dorisoy/Dorisoy.BTRemote/3D_PCB1_1_2026-03-20.png

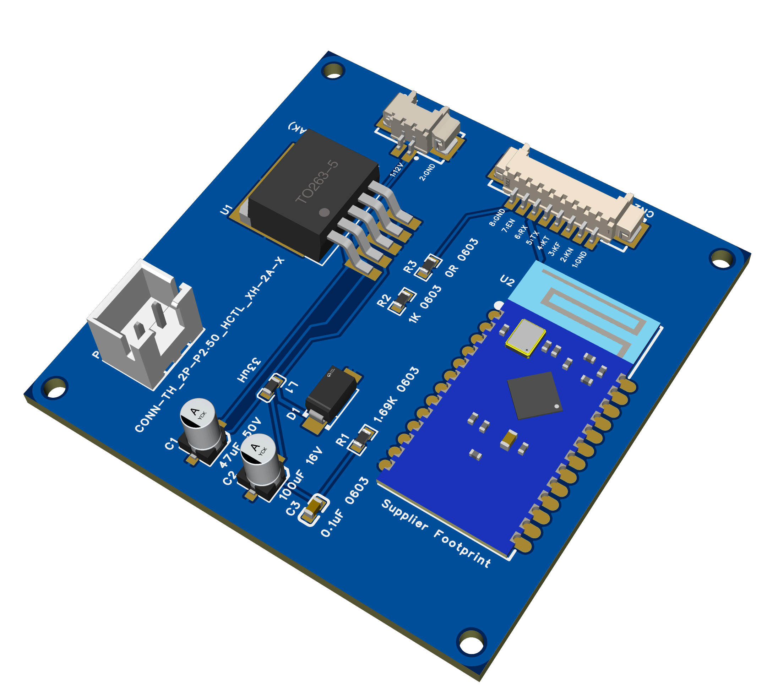
3D_PCB1_1_2026-03-20.png
