dorisoy/Dorisoy.BTRemote/b5cf8264-b6f2-4770-b07a-7b15c572c21a.png

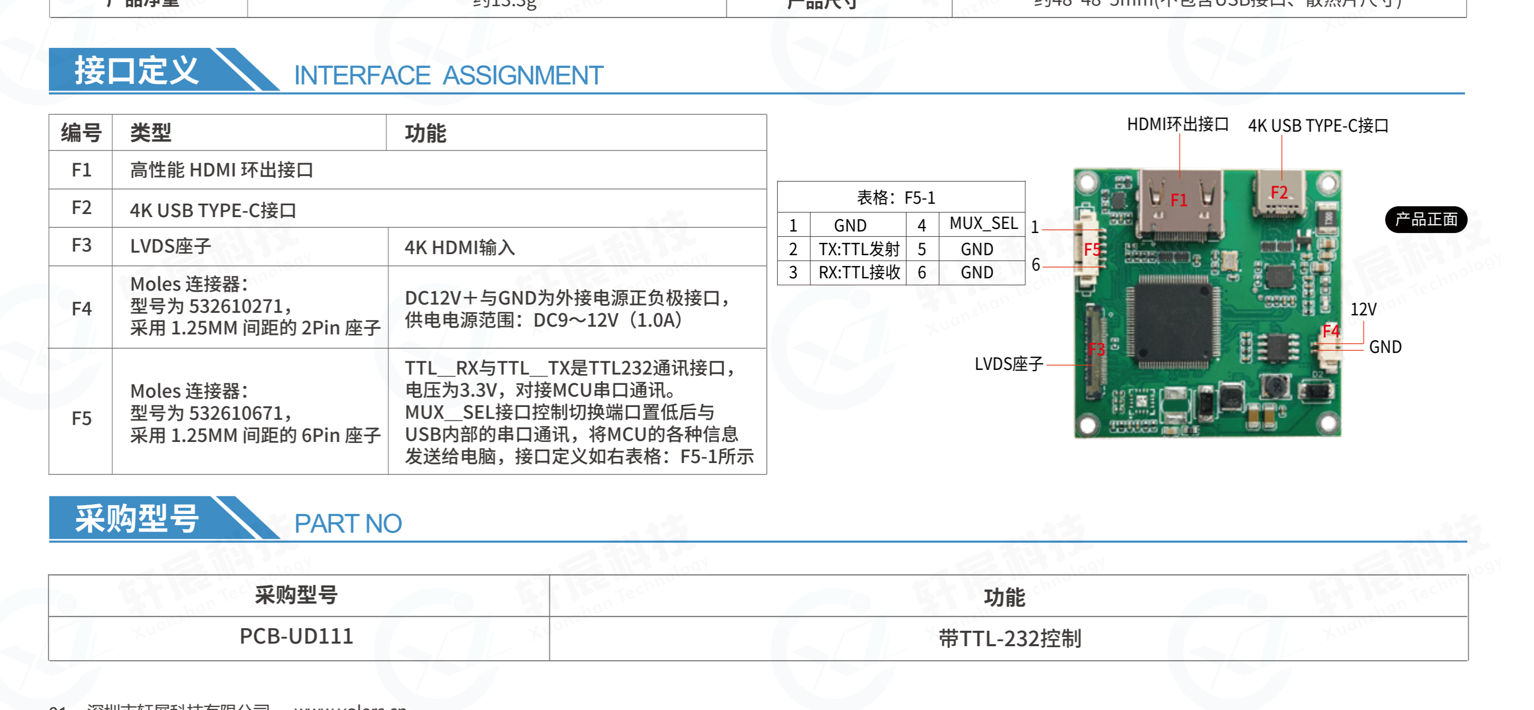
b5cf8264-b6f2-4770-b07a-7b15c572c21a.png
