dorisoy/Dorisoy.BTRemote/PCB_PCB1_1_2026-03-20.png

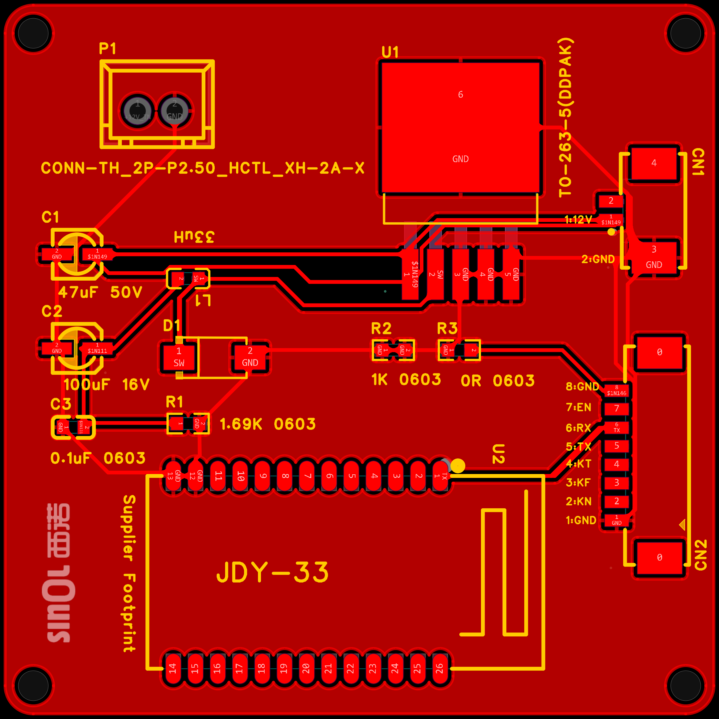
PCB_PCB1_1_2026-03-20.png
