dorisoy/Dorisoy.BTRemote/SCH_USB_TYPE-C 采集模块扩展板(2P)_1-P1_2026-03-26.png

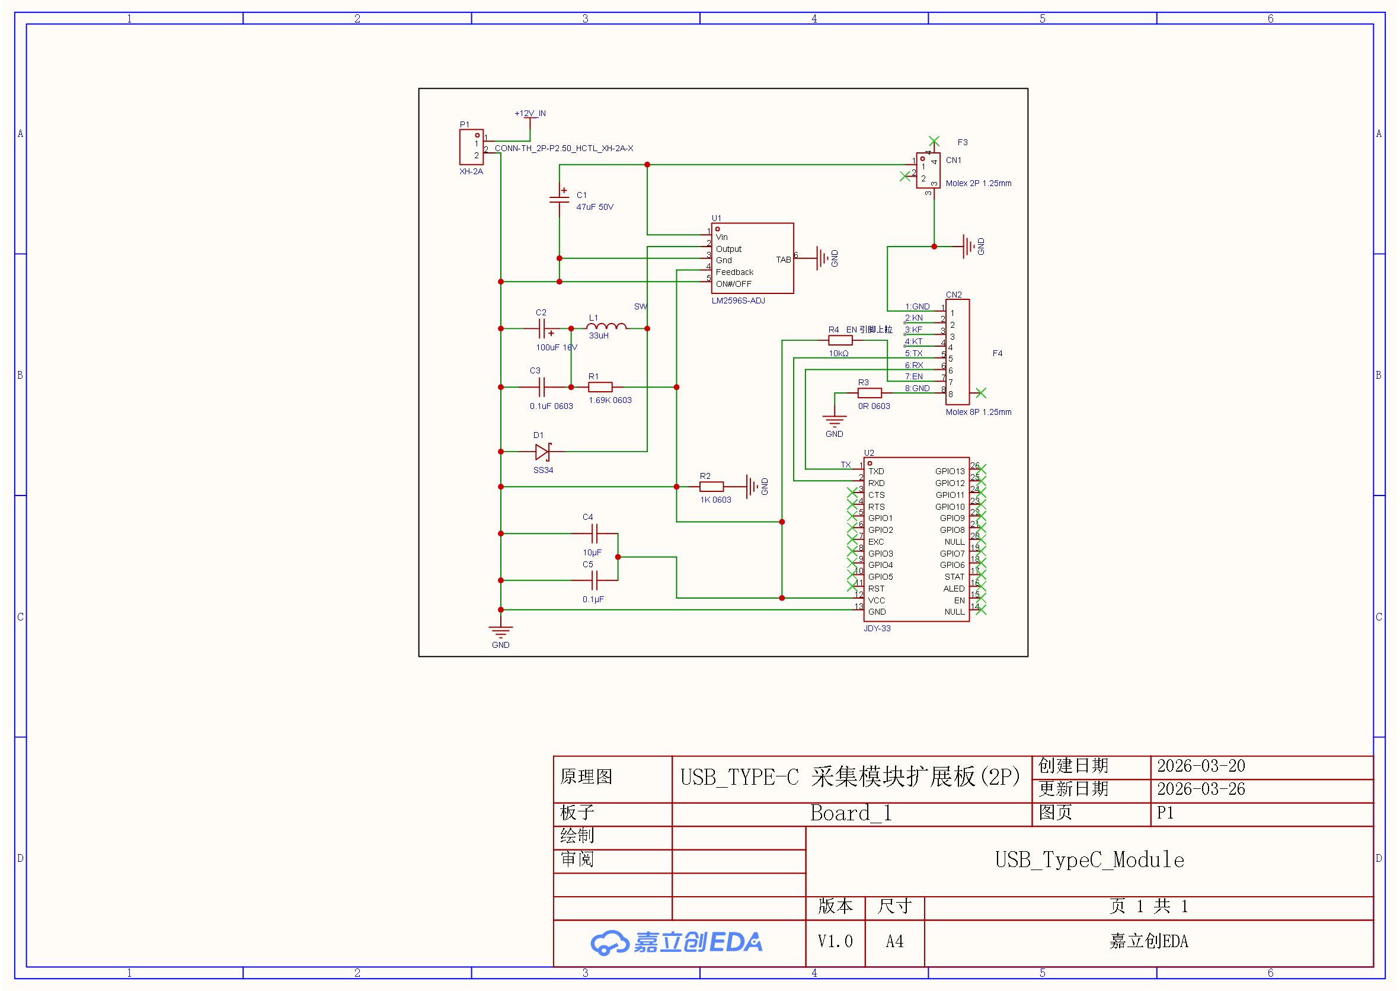
SCH_USB_TYPE-C 采集模块扩展板(2P)_1-P1_2026-03-26.png
