dorisoy/Dorisoy.BTRemote/SCH_蓝牙_1-蓝牙_2026-03-27.png

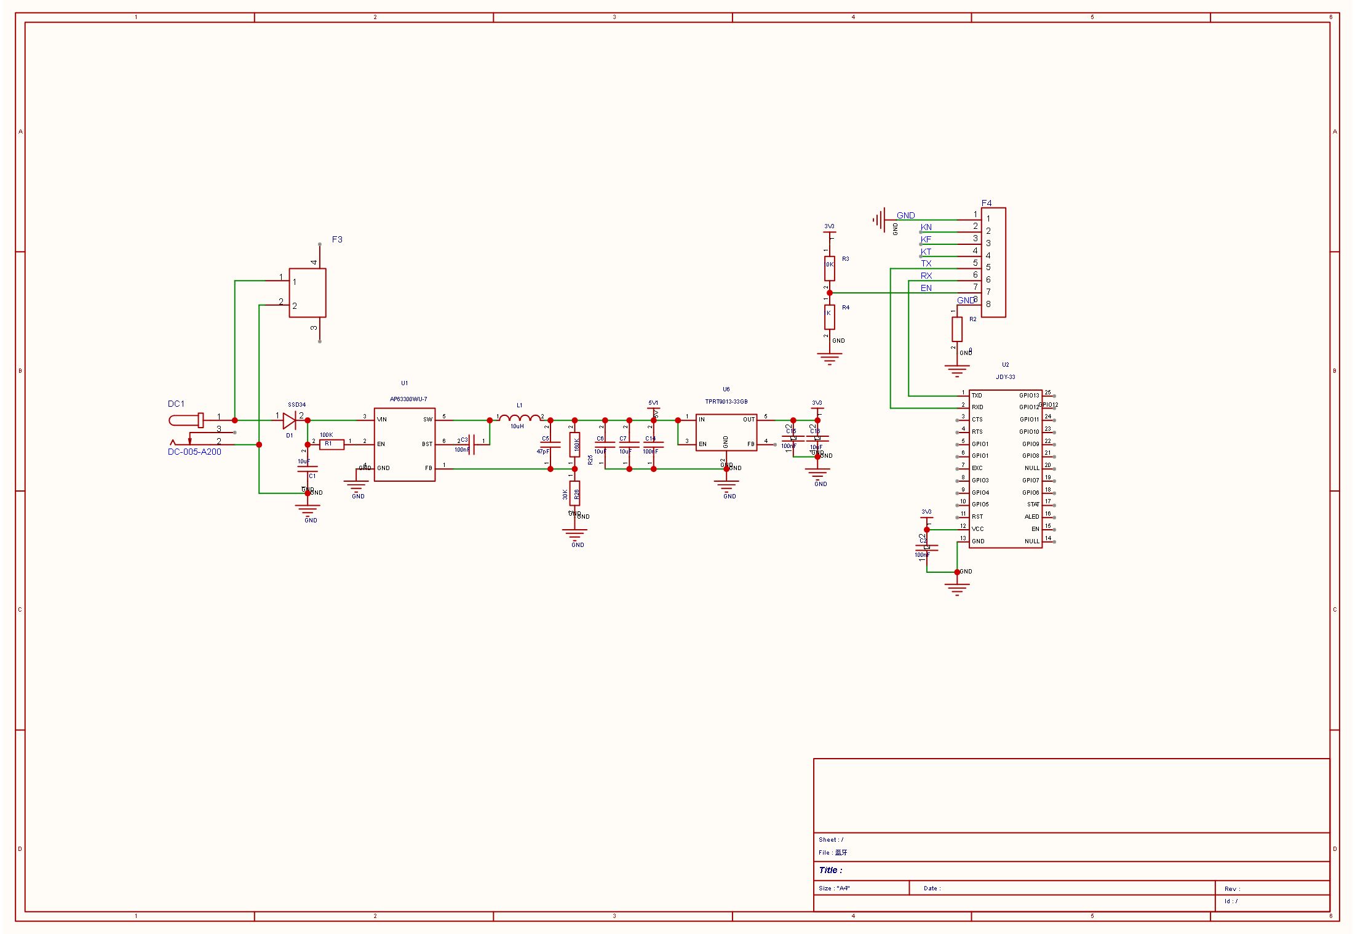
SCH_蓝牙_1-蓝牙_2026-03-27.png
