dorisoy/Dorisoy.BTRemote/微信图片_20260327112640_236_177.jpg

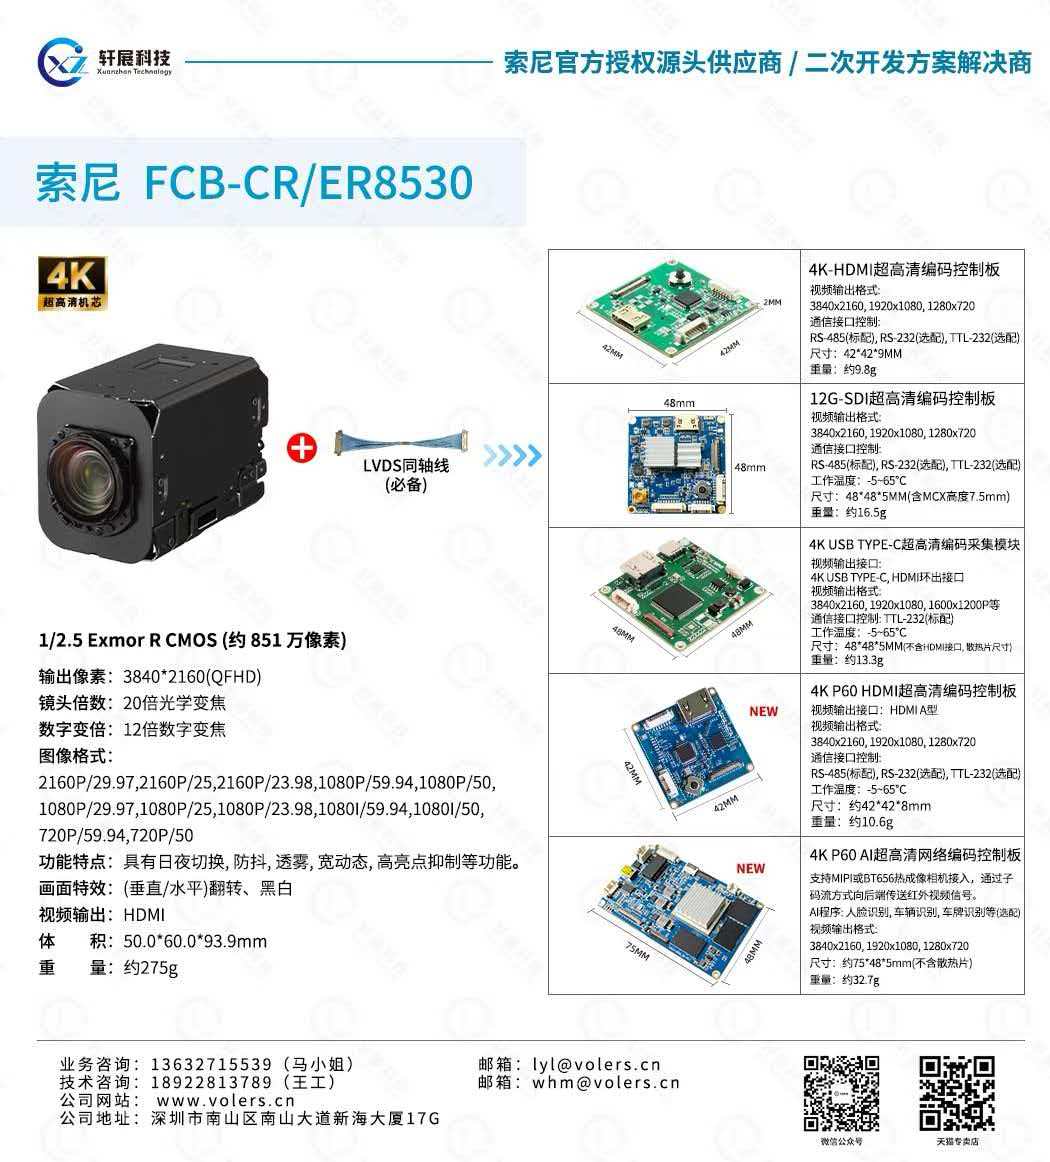
微信图片_20260327112640_236_177.jpg
