dorisoy/Dorisoy.BTRemote/微信图片_20260327113401_247_177.png

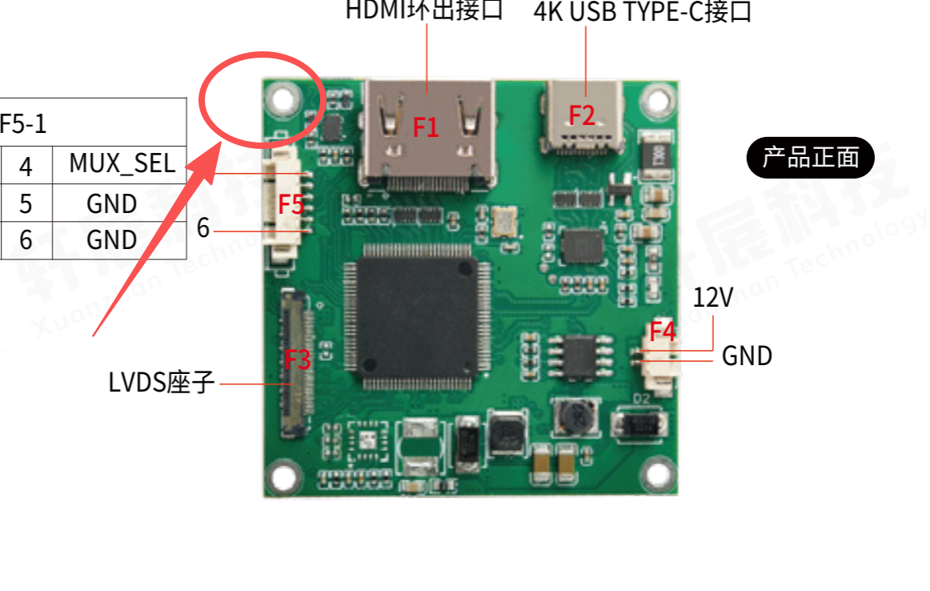
微信图片_20260327113401_247_177.png
