dorisoy/Dorisoy.BTRemote/(list of files, drawings)

Other design files:
ProPrj_蓝牙_KICAD_2026-03-27.epro
